banchan86/harp-device.timestampgeneratorgen3/docs/apidoc/Harp_TimestampGeneratorGen3_Config.md

---
uid: Harp.TimestampGeneratorGen3.Config
---

### Charge or discharge the battery

:::workflow
Charge or discharge the battery
:::

### Run battery cycle

:::workflow
Run battery cycle
:::
