banchan86/harp-device.timestampgeneratorgen3/docs/apidoc/Harp_TimestampGeneratorGen3_CreateTimerFrequencyPayload.md

---
uid: Harp.TimestampGeneratorGen3.CreateTimerFrequencyPayload
---

### Enable Timer events

:::workflow
Enable Timer events
:::
