banchan86/harp-device.timestampgeneratorgen3/docs/apidoc/Harp_TimestampGeneratorGen3_TimerFrequency.md

---
uid: Harp.TimestampGeneratorGen3.TimerFrequency
---

### Enable Timer events

:::workflow
Enable Timer events
:::
