banchan86/harp-device.timestampgeneratorgen3/docs/apidoc/Harp_TimestampGeneratorGen3_BatteryRate.md

---
uid: Harp.TimestampGeneratorGen3.BatteryRate
---

### Configure the battery rate

:::workflow
Configure the battery rate
:::
