banchan86/harp-device.timestampgeneratorgen3/docs/apidoc/Harp_TimestampGeneratorGen3_BatteryThresholdLow.md

---
uid: Harp.TimestampGeneratorGen3.BatteryThresholdLow
---

### Set charging thresholds

:::workflow
Set charging thresholds
:::
