banchan86/harp-device.timestampgeneratorgen3/docs/apidoc/Harp_TimestampGeneratorGen3_CreateBatteryRatePayload.md

---
uid: Harp.TimestampGeneratorGen3.CreateBatteryRatePayload
---

### Configure the battery rate

:::workflow
Configure the battery rate
:::
