banchan86/harp-device.timestampgeneratorgen3/docs/apidoc/Harp_TimestampGeneratorGen3_Battery.md

---
uid: Harp.TimestampGeneratorGen3.Battery
---

### Check battery charge

:::workflow
Check battery charge
:::

### Visualize battery events

:::workflow
Visualize battery events
:::
