banchan86/harp-device.timestampgeneratorgen3/docs/apidoc/Harp_TimestampGeneratorGen3_BatteryThresholdHigh.md

---
uid: Harp.TimestampGeneratorGen3.BatteryThresholdHigh
---

### Set charging thresholds

:::workflow
Set charging thresholds
:::
