banchan86/harp-device.timestampgeneratorgen3/docs/apidoc/Harp_TimestampGeneratorGen3_CreateBatteryThresholdLowPayload.md

---
uid: Harp.TimestampGeneratorGen3.CreateBatteryThresholdLowPayload
---

### Set charging thresholds

:::workflow
Set charging thresholds
:::
