banchan86/harp-device.timestampgeneratorgen3/docs/apidoc/Harp_TimestampGeneratorGen3_DeviceDataWriter.md

---
uid: Harp.TimestampGeneratorGen3.DeviceDataWriter
---

### Harp device pattern

:::workflow
Harp device pattern
:::
