banchan86/harp-device.timestampgeneratorgen3/docs/apidoc/Harp_TimestampGeneratorGen3_Timer.md

---
uid: Harp.TimestampGeneratorGen3.Timer
---

### Set Counter Value

:::workflow
Set Counter Value
:::

### Observe Timer Events

:::workflow
Observe Timer Events
:::

### Timestamp Software Events

:::workflow
Timestamp Software Events
:::
