banchan86/harp-device.timestampgeneratorgen3/docs/apidoc/Harp_TimestampGeneratorGen3_CreateBatteryThresholdHighPayload.md

---
uid: Harp.TimestampGeneratorGen3.CreateBatteryThresholdHighPayload
---

### Set Charging Thresholds

:::workflow
Set Charging Thresholds
:::
