banchan86/harp-device.timestampgeneratorgen3/docs/apidoc/Harp_TimestampGeneratorGen3_DevicesConnected.md

---
uid: Harp.TimestampGeneratorGen3.DevicesConnected
---

### Check Connected Devices

:::workflow
Check Connected Devices
:::
