banchan86/harp-device.timestampgeneratorgen3/docs/articles/generate-counter-events.md

# Generate counter events

Besides the [heartbeat](./set-clock.md) event, the Timestamp Generator Gen3 can also report a high-frequency counter (50–1000 Hz) as [`Timer`] events. Each event carries an incrementing value timestamped with the device clock, which is useful for inspecting the clock and detecting dropped messages.  It can also be used to assign Harp timestamps to data that are not generated by Harp devices, such as software-generated events, thereby timestamping them on the same clock as the Harp devices.

This article covers how to enable and visualize the [`Timer`] events, set the counter value, and assign Harp timestamps to software events.

The complete workflow is shown below. Copy and paste it into Bonsai to get started immediately, or build each section by following the step-by-step instructions in the following sections.

:::workflow
Generate counter events
:::

> [!NOTE]
> The [`Timer`] event is different from the [`Timer (Reactive)`] Bonsai operator used in the [Set clock](set-clock.md#alternative-set-clock-with-timer) article. [`Timer`] is an event from a hardware counter on the device, whereas [`Timer (Reactive)`] is a software trigger in Bonsai that uses the operating system clock to count elapsed time.

> [!WARNING]
> For the rest of these workflows, use the device-specific versions of the operators, e.g. `Device (Harp.TimestampGeneratorGen3)` instead of `Device (Harp)`. If correctly selected, the names of these operators in the workflow panel will change to reflect either the name of the device or the selected register/payload.

## Enable Timer events

The [`Timer`] events are disabled by default, so set the [`TimerFrequency`] to start them.

:::workflow
Enable Timer events
:::

- Insert a [`KeyDown`] operator and set the `Filter` property to `A`.
- Insert a [`CreateMessage`] operator and configure the following properties:
    - `Payload` - Select `TimerFrequencyPayload`.
    - `TimerFrequency` - Select the event frequency (e.g. `Timer50Hz` to generate 50 counts per second). To disable the events in the future, select `Disabled`.
- Insert a [`MulticastSubject`] operator named `TimestampGeneratorGen3 Commands`.

Run the workflow and press <kbd>A</kbd>. The device starts reporting [`Timer`] events at 50 Hz (covered in the next section).

## Visualize Timer events

Each [`Timer`] event carries the current counter value and the timestamp at which it was generated. The workflow below will show you how to decode and visualize the [`Timer`] events:

:::workflow
Visualize Timer events
:::

- Insert a [`SubscribeSubject`] operator named `TimestampGeneratorGen3 Events`.
- Insert a [`Parse`] operator and set the `Register` property to `TimestampedTimer`.
- Insert a [`VisualizerWindow`] operator.

Run the workflow and press <kbd>A</kbd> to enable the counter. The visualizer will display:

```text
4778@95.563344
4779@95.583344
```

The first number is the counter value, and the second number is the timestamp on the device clock.

> [!NOTE]
> To detect dropped messages, analyze the logged data to check that the counter is increasing sequentially by one without any skipped numbers.

## Set counter value

Writing a value to [`Timer`] sets the value of the counter. This is useful for resetting the counter to zero at the start of a session.

:::workflow
Set counter value
:::

- Insert a [`KeyDown`] operator and set the `Filter` property to `S`.
- Insert a [`CreateMessage`] operator and configure the following properties:
    - `Payload` - Select `TimerPayload`.
    - `Timer` - Enter `0` to reset the counter.
- Insert a [`MulticastSubject`] operator named `TimestampGeneratorGen3 Commands`.

Run the workflow and press <kbd>S</kbd>. The counter value in the visualizer window resets to zero, like this:

```text
0@99.563344
1@99.583344
```

> [!TIP]
> To reset the onboard clock that timestamps the events, see the [Set clock](set-clock.md) article.

## Timestamp software events

Software events, such as key presses, can be assigned Harp timestamps by pairing them with the latest [`Timer`] event.

:::workflow
Timestamp software events
:::

- Insert a [`KeyDown`] operator and set the `Filter` property to `D`. This is the software event that will be timestamped.
- Insert a [`WithLatestFrom`] operator.

In a separate branch:

- Insert a [`SubscribeSubject`] operator named `TimestampGeneratorGen3 Events`.
- Insert a [`Parse`] operator and set the `Register` property to `TimestampedTimer`.

To combine the two branches:

- Connect the [`Parse`] operator to the [`WithLatestFrom`]. Each key press will now be paired with the latest [`Timer`] event.
- Insert a [`VisualizerWindow`] operator to display the paired events.

Run the workflow and press <kbd>D</kbd>. Each key press appears in the visualizer window paired with the latest counter and timestamp:

```text
(D, 141404@19990.36)
(D, 146440@20000.66)
```

> [!NOTE]
> The timestamp resolution with this strategy is set by the [`TimerFrequency`] (e.g. 20 ms at 50 Hz). Use a higher frequency for finer resolution. The pairing is done in software by Bonsai, and Windows is not a real-time operating system, so it is not ideal for high-precision timing applications. For that, log the events on a hardware clock instead, such as a digital input on another Harp device.

[!INCLUDE [](../includes/version-footer.md)]

<!--Reference Style Links -->
[`Timer`]: xref:Harp.TimestampGeneratorGen3.Timer
[`TimerFrequency`]: xref:Harp.TimestampGeneratorGen3.TimerFrequency
[`Timer (Reactive)`]: xref:Bonsai.Reactive.Timer
[`CreateMessage`]: xref:Harp.TimestampGeneratorGen3.CreateMessage
[`Parse`]: xref:Harp.TimestampGeneratorGen3.Parse
[`VisualizerWindow`]: xref:Bonsai.Design.VisualizerWindow
[`KeyDown`]: xref:Bonsai.Windows.Input.KeyDown
[`SubscribeSubject`]: xref:Bonsai.Expressions.SubscribeSubject
[`WithLatestFrom`]: xref:Bonsai.Reactive.WithLatestFrom
[`MulticastSubject`]: xref:Bonsai.Expressions.MulticastSubject
