banchan86/harp-device.timestampgeneratorgen3/Hardware/PCB/README.md

# Harp Timestamp Generator Gen1

## Licensing

The designs, documentation, and photos available in this repository are free: you can redistribute it and/or modify it under the terms of the used license.
Check file named LICENSE.

Copyright OEPS 2021-2026

<br />This work is licensed under a <a rel="license" href="http://creativecommons.org/licenses/by-nc-sa/3.0/igo/">Creative Commons Attribution-NonCommercial-ShareAlike 3.0 IGO License</a>.

If your are interested in obtaining a license to sell this device, please contact info@oeps.tech

[1]: https://docs.google.com/spreadsheets/d/1aobmmEzBDethzIlrm1eg0eYkBqlyX3s9WbA9KgRwVQI/edit?usp=sharing
