banchan86/harp-device.timestampgeneratorgen3/hardware/PCB/timestamp generator Gen3/manufacturing/bom/harp timestamp generator Gen3.csv

# | Qty | Reference | Value | Tolerance | Footprint | TempCo | Voltage | DNP | OEPSPN | MPN | OEPS Description
1 | 1 | BATEN1 | 7101MD9ABE |  | harp_timestamp_generator_Gen3:2M1-SP1-T2-B4-M6RE |  |  |  | OEPS100019 | 7101MD9ABE | OTHER: SWITCH TOGGLE SPDT 0.4VA 20V [7101MD9ABE] [TH]
2 | 1 | BUTTON1 | CFPA |  | harp_timestamp_generator_Gen3:CFPA |  |  |  | OEPS100018 | CFPA-1FB4-A2T | OTHER: SWITCH PUSH SPDT 0.4VA 28V [CFPA-1FB4-A2T] [SMD]
3 | 1 | C1 | 4.7nF | 10% | Capacitor_SMD:C_0402_1005Metric | X7R | 100V |  | OEPS010017 | 885012205084 | CAPACITOR: SMD CER 0402 4.7nF 100V ±10% X7R [885012205084] [SMD]
4 | 30 | C2,C3,C5,C8,C9,C10,C12,C16,C19,C20,C21,C23,C24,C25,C26,C27,C28,C29,C30,C31,C32,C33,C34,C35,C36,C39,C40,C41,C42,C43 | 100nF | 10% | Capacitor_SMD:C_0402_1005Metric | X7R | 50V |  | OEPS010016 | CGA2B3X7R1H104K050BB | CAPACITOR: SMD CER 0402 100nF 50V ±10% X7R [CGA2B3X7R1H104K050BB] [SMD]
5 | 5 | C4,C14,C15,C37,C38 | 4.7uF | 10% | Capacitor_SMD:C_0603_1608Metric | X6S | 16V |  | OEPS010018 | C1608X6S1C475K080AC | CAPACITOR: SMD CER 0603 4.7uF 16V ±10% X6S [C1608X6S1C475K080AC] [SMD]
6 | 2 | C6,C7 | 47pF | 5% | Capacitor_SMD:C_0402_1005Metric | C0G | 50V |  | OEPS010011 | 04025A470JAT2A | CAPACITOR: SMD CER 0402 47pF 50V ±5% C0G [04025A470JAT2A] [SMD]
7 | 1 | C11 | 100u | 20% | harp_timestamp_generator_Gen3:TT2D6_334 |  | 25V |  | OEPS210005 | EEU-FM1E101B | CAPACITOR POL: TH ALUM 100uF 25V ±20% 130mOhm [EEU-FM1E101B] [TH]
8 | 2 | C13,C17 | 10nF | 10% | Capacitor_SMD:C_0402_1005Metric | X7R | 25V |  | OEPS010002 | GCM155R71E103KA37D | CAPACITOR: SMD CER 0402 10nF 25V ±10% X7R [GCM155R71E103KA37D] [SMD]
9 | 1 | C18 | 330pF | 5% | Capacitor_SMD:C_0402_1005Metric | C0G | 50V |  | OEPS010020 | C0402C331J5GAC7867 | CAPACITOR: SMD CER 0402 330pF 50V ±5% C0G [C0402C331J5GAC7867] [SMD]
10 | 1 | C22 | 330nF | 10% | Capacitor_SMD:C_0402_1005Metric | X5R | 10V |  | OEPS010021 | GRM155R61A334KE15D | CAPACITOR: SMD CER 0402 330nF 10V ±10% X5R [GRM155R61A334KE15D] [SMD]
11 | 7 | CLKIN1,CLKOUT1,CLKOUT2,CLKOUT3,CLKOUT4,CLKOUT5,CLKOUT6 | 35RASMT2BHNTRX |  | harp_timestamp_generator_Gen3:35RASMT2BHNTRX |  |  |  | OEPS070025 | 35RASMT2BHNTRX | CONNECTOR: 3.5MM JACK STEREO 90º [35RASMT2BHNTRX] [SMD]
12 | 4 | D1,D2,D3,D4 | CDBW140-G |  | Diode_SMD:D_SOD-123 |  | 40V |  | OEPS030034 | CDBW140-G | DIODE: DIODE SCHOTTKY 40V 1A [CDBW140-G] [SOD-123]
13 | 1 | F1 | BLM18SG331TN1D |  | Resistor_SMD:R_0603_1608Metric |  |  |  | OEPS040004 | BLM18SG331TN1D | INDUCTOR: FERRITE BEAD SMD 330Ω 1.5A 70mΩ [BLM18SG331TN1D] [0603]
14 | 1 | IC1 | USBLC6-2SC6 |  | Package_TO_SOT_SMD:SOT-23-6 |  |  |  | OEPS030010 | USBLC6-2SC6 | DIODE: TVS DIODE 5.25VWM 17VC [USBLC6-2SC6] [SOT-23-6]
15 | 1 | IC2 | FT232RL |  | Package_SO:SSOP-28_5.3x10.2mm_P0.65mm |  |  |  | OEPS080013 | FT232RL-REEL | IC: USB Interface IC USB to Serial UART (OEPS NP1 073) [FT232RL-REEL] [SSOP-28]
16 | 1 | IC3 | TPS2114 |  | Package_SO:TSSOP-8_4.4x3mm_P0.65mm |  |  |  | OEPS080039 | TPS2114APW | IC: AUTOSWITCHING POWER MUX [TPS2114APW] [8-TSSOP]
17 | 2 | IC4,IC14 | LP5951MFX-3.3/NOPB |  | Package_TO_SOT_SMD:TSOT-23-5 |  |  |  | OEPS080026 | LP5951MFX-3.3/NOPB | IC: LDO 3.3V 150mA [LP5951MFX-3.3/NOPB] [SOT-23-5]
18 | 1 | IC5 | MCP73831 |  | Package_TO_SOT_SMD:TSOT-23-5 |  |  |  | OEPS080035 | MCP73831T-2ATI/OT | IC: BATTERY LI-POLYMER CHARGER [MCP73831T-2ATI/OT] [SOT-23-5]
19 | 1 | IC6 | ATXMEGA16A4U-A |  | Package_QFP:LQFP-44_10x10mm_P0.8mm |  |  |  | OEPS080032 | ATXMEGA16A4U-AU | IC: MCU ATXMEGA A4U 8bits 16KB [ATXMEGA16A4U-AU] [TQFP-44]
20 | 3 | IC7,IC8,IC17 | SN74LVC1G125DBVT |  | Package_TO_SOT_SMD:SOT-23-5 |  |  |  | OEPS080029 | SN74LVC1G125DBVT | IC: BUFFER NON-INVERT 1CH 3-STATE [SN74LVC1G125DBVT] [SOT-23-5]
21 | 6 | IC9,IC10,IC11,IC12,IC13,IC15 | SI8621BC |  | Package_SO:SOIC-8_3.9x4.9mm_P1.27mm |  |  |  | OEPS080031 | SI8621BC-B-ISR | IC: DIGITAL ISOLATOR 1+1WAY [SI8621BC-B-ISR] [8-SOIC]
22 | 2 | IC16,IC18 | M74VHC1GT126DF1G |  | Package_TO_SOT_SMD:SOT-353_SC-70-5 |  |  |  | OEPS080033 | M74VHC1GT126DF1G | IC: BUFFER NON-INVERT 1CH 3-STATE [M74VHC1GT126DF1G] [SC-70-5]
23 | 1 | L1 | MI0805K400R-10 |  | Resistor_SMD:R_0805_2012Metric |  |  |  | OEPS040003 | MI0805K400R-10 | INDUCTOR: FERRITE BEAD SMD 40Ω 2A 50mΩ [MI0805K400R-10] [0805]
24 | 5 | LED1,LED2,LED3,LED4,LED5 | 569-0111-100F |  | harp_timestamp_generator_Gen3:569-011X-X00_LED_ARRAY |  |  |  | OEPS030007 | 569-0111-100F | DIODE: LED DUAL Red 635nm 20mA [569-0111-100F] [TH]
25 | 1 | OSC1 | ECS-TXO-3225MV-320-TR |  | harp_timestamp_generator_Gen3:OSCILLATOR_3.2X2.5 |  |  |  | OEPS080257 | ECS-TXO-3225MV-320-TR | IC: XTAL OSC TCXO 32MHz HCMOS 2.5ppm [ECS-TXO-3225MV-320-TR] [4-SMD]
26 | 1 | PDI1 | 67996-206HLF |  | Connector_PinHeader_2.54mm:PinHeader_2x03_P2.54mm_Vertical |  |  |  | OEPS070015 | 67996-206HLF | CONNECTOR: HEADER 2.54MM straight 2x3POS [67996-206HLF] [TH]
27 | 2 | Q1,Q6 | DMG1012UW |  | Package_TO_SOT_SMD:SOT-323_SC-70 |  |  |  | OEPS060010 | DMG1012UW-7 | TRANSISTOR: MOSFET N-CH 20V 1A [DMG1012UW-7] [SOT-323]
28 | 1 | Q2 | SBC817 |  | Package_TO_SOT_SMD:SOT-23 |  |  |  | OEPS060008 | SBC817-40LT1G | TRANSISTOR: BJT NPN 45V 0.5A [SBC817-40LT1G] [SOT-23-3]
29 | 1 | Q3 | PJC7401_R1_00001 |  | Package_TO_SOT_SMD:SOT-323_SC-70 |  |  | DNP | OEPS060026 | PJC7401_R1_00001 | TRANSISTOR: MOSFET P-CH 30V 1.5A [PJC7401_R1_00001] [SOT-323]
30 | 1 | Q4 | DMP2035U-7 |  | Package_TO_SOT_SMD:SOT-23 |  |  |  | OEPS060011 | DMP2035U-7 | TRANSISTOR: MOSFET P-CH 20V 3.6A [DMP2035U-7] [SOT-23-3]
31 | 1 | Q5 | PJC7401_R1_00001 |  | Package_TO_SOT_SMD:SOT-323_SC-70 |  |  |  | OEPS060026 | PJC7401_R1_00001 | TRANSISTOR: MOSFET P-CH 30V 1.5A [PJC7401_R1_00001] [SOT-323]
32 | 1 | Q7 | BC817-40W |  | Package_TO_SOT_SMD:SOT-323_SC-70 |  |  |  | OEPS060007 | BC817-40W,135 | TRANSISTOR: BJT NPN 45V 0.5A [BC817-40W,135] [SOT-323]
33 | 1 | R1 | 1M | 1% | Resistor_SMD:R_0402_1005Metric |  |  |  | OEPS020026 | CRCW04021M00FKED | RESISTOR: SMD 0402 1MΩ ±1% 0.063W [CRCW04021M00FKED] [SMD]
34 | 9 | R2,R7,R15,R20,R22,R23,R24,R26,R48 | 10k | 1% | Resistor_SMD:R_0402_1005Metric |  |  |  | OEPS020030 | CRCW040210K0FKED | RESISTOR: SMD 0402 10kΩ ±1% 0.063W [CRCW040210K0FKED] [SMD]
35 | 2 | R3,R4 | 5.1k | 1% | Resistor_SMD:R_0402_1005Metric |  |  |  | OEPS020173 | ERJ-2RKF5101X | RESISTOR: SMD 0402 5.1kΩ ±1% 0.100W [ERJ-2RKF5101X] [SMD]
36 | 2 | R5,R6 | DNP |  | Resistor_SMD:R_0402_1005Metric |  |  | DNP | OEPS000000 | DNP | DNP: Do Not Populate (DNI)
37 | 1 | R8 | 20R | 1% | Resistor_SMD:R_2512_6332Metric |  |  |  | OEPS020045 | CRM2512-FX-20R0ELF | RESISTOR: SMD 2512 20Ω ±1% 2W [CRM2512-FX-20R0ELF] [SMD]
38 | 2 | R9,R21 | 100k | 1% | Resistor_SMD:R_0402_1005Metric |  |  |  | OEPS020019 | ERJ-2RKF1003X | RESISTOR: SMD 0402 100kΩ ±1% 0.100W [ERJ-2RKF1003X] [SMD]
39 | 12 | R10,R32,R33,R34,R35,R36,R42,R43,R44,R45,R46,R_I_MAX1 | 1k | 1% | Resistor_SMD:R_0402_1005Metric |  |  |  | OEPS020027 | CRCW04021K00FKED | RESISTOR: SMD 0402 1kΩ ±1% 0.063W [CRCW04021K00FKED] [SMD]
40 | 1 | R11 | 100k | 1% | Resistor_SMD:R_0402_1005Metric |  |  | DNP | OEPS020019 | ERJ-2RKF1003X | RESISTOR: SMD 0402 100kΩ ±1% 0.100W [ERJ-2RKF1003X] [SMD]
41 | 1 | R12 | 100R | 1% | Resistor_SMD:R_0603_1608Metric |  |  | DNP | OEPS020042 | CRCW0603100RFKEAHP | RESISTOR: SMD 0603 100Ω ±1% 0.333W [CRCW0603100RFKEAHP] [SMD]
42 | 3 | R13,R14,R17 | 4.53k | 0.1% | Resistor_SMD:R_0402_1005Metric |  |  |  | OEPS020040 | RT0402BRD074K53L | RESISTOR: SMD 0402 4.53kΩ ±0.1% 0.063W [RT0402BRD074K53L] [SMD]
43 | 2 | R16,R19 | 14.7k | 0.1% | Resistor_SMD:R_0402_1005Metric |  |  |  | OEPS020047 | RT0402BRD0714K7L | RESISTOR: SMD 0402 14.7kΩ ±0.1% 0.063W [RT0402BRD0714K7L] [SMD]
44 | 1 | R18 | 51k | 0.1% | Resistor_SMD:R_0402_1005Metric |  |  |  | OEPS020046 | ERA-2AEB513X | RESISTOR: SMD 0402 51kΩ ±0.1% 0.063W [ERA-2AEB513X] [SMD]
45 | 1 | R25 | 10R | 5% | Resistor_SMD:R_0402_1005Metric |  |  |  | OEPS020041 | ERJ-PA2J100X | RESISTOR: SMD 0402 10Ω ±5% 0.25W [ERJ-PA2J100X] [SMD]
46 | 10 | R27,R28,R29,R30,R31,R37,R38,R39,R40,R41 | 330R | 1% | Resistor_SMD:R_0402_1005Metric |  |  |  | OEPS020037 | RC0402FR-07330RL | RESISTOR: SMD 0402 330Ω ±1% 0.063W [RC0402FR-07330RL] [SMD]
47 | 2 | R47,R49 | 100R | 1% | Resistor_SMD:R_0603_1608Metric |  |  |  | OEPS020042 | CRCW0603100RFKEAHP | RESISTOR: SMD 0603 100Ω ±1% 0.333W [CRCW0603100RFKEAHP] [SMD]
48 | 1 | SV1 | SBH11-PBPC-D05-RA-BK |  | Connector_IDC:IDC-Header_2x05_P2.54mm_Horizontal |  |  |  | OEPS070027 | SBH11-PBPC-D05-RA-BK | CONNECTOR: HEADER 2.54MM R/A 2x5POS [SBH11-PBPC-D05-RA-BK] [TH]
49 | 10 | T1,T2,T3,T4,T5,T6,T7,T8,T9,T10 | BC850 |  | Package_TO_SOT_SMD:SOT-23 |  |  |  | OEPS060006 | BC850C,215 | TRANSISTOR: BJT NPN 45V 0.1A [BC850C,215] [SOT-23-3]
50 | 1 | U1 | XC6135C35AMR-G |  | Package_TO_SOT_SMD:SOT-23-5 |  |  |  | OEPS080252 | XC6135C35AMR-G | IC: ULTRA-LOW POWER (44nA) VOLTAGE DETECTOR [XC6135C35AMR-G] [SOT-25]
51 | 1 | USB1 | USB4105-GF-A |  | Connector_USB:USB_C_Receptacle_GCT_USB4105-xx-A_16P_TopMnt_Horizontal |  |  |  | OEPS070105 | USB4105-GF-A | CONNECTOR: USB2.0 TYPE C 16P SMD R/A [USB4105-GF-A] [SMD/TH]
52 | 1 | X1 | B2B-XH-A(LF)(SN) |  | harp_timestamp_generator_Gen3:JST-XH-02-PACKAGE-ROUND-PAD |  |  |  | OEPS070028 | B2B-XH-A(LF)(SN) | CONNECTOR: HEADER JST VERT 2.5MM 2POS [B2B-XH-A(LF)(SN)] [TH]
