banchan86/harp-device.timestampgeneratorgen3/hardware/PCB/timestamp generator Gen3/crystals.xlsx

Digikey PN | MNF PN | @25C [ppm] | Range of temperatures [ppm] | Supply Change [ppm] | Load Change [ppm] | Aging/year [ppm] |  | Dimensions [mm] | Pinout | Current [mA] | Type
XC2259CT-ND | ECS-TXO-2520-33-320-AN-TR | 2 | 2.5 | 0.2 | 0.2 | 1 | 5.9 | 2.5 x 2.0 | En/Dis, GND, OUT, VDD | 6 | HCMOS TXCO
1908-1044-1-ND | O 32,0-JT32C-A-K-3,3-LF | 0.5 | 2.5 | 0.2 | 0.2 | 1 | 4.4 | 3.2 x 2.5 | En/Dis, GND, OUT, VDD | 4.8 | HCMOS TXCO
50-ECS-TXO-2520MV-320-AN-CT-ND | ECS-TXO-2520MV-320-AN-TR | 1.5 | 2.5 | 0.3 | 0.3 | 1 | 5.6 | 2.5 x 2.0 | En/Dis, GND, OUT, VDD | 6 | CMOS TXCO
50-ECS-TXO-2520MV-320-AY-CT-ND | ECS-TXO-2520MV-320-AY-TR | 1.5 | 2.5 | 0.3 | 0.3 | 1 | 5.6 | 2.5 x 2.0 | En/Dis, GND, OUT, VDD | 6 | CMOS TXCO
50-ECS-TXO-25CSMV-320-BM-CT-ND | ECS-TXO-25CSMV-320-BM-TR | 2 | 1 | 0.2 | 0.2 | 1 | 4.4 | 2.5 x 2.0 | GND, GND, OUT, VDD | 2.5 | Clipped Sinewave TSCO
