banchan86/harp-device.timestampgeneratorgen3/hardware/PCB/timestamp generator Gen3/harp timestamp generator Gen3.kicad_pcb

## KiCad design hardware/PCB/timestamp generator Gen3/harp timestamp generator Gen3.kicad_pcb (2026-11-14)

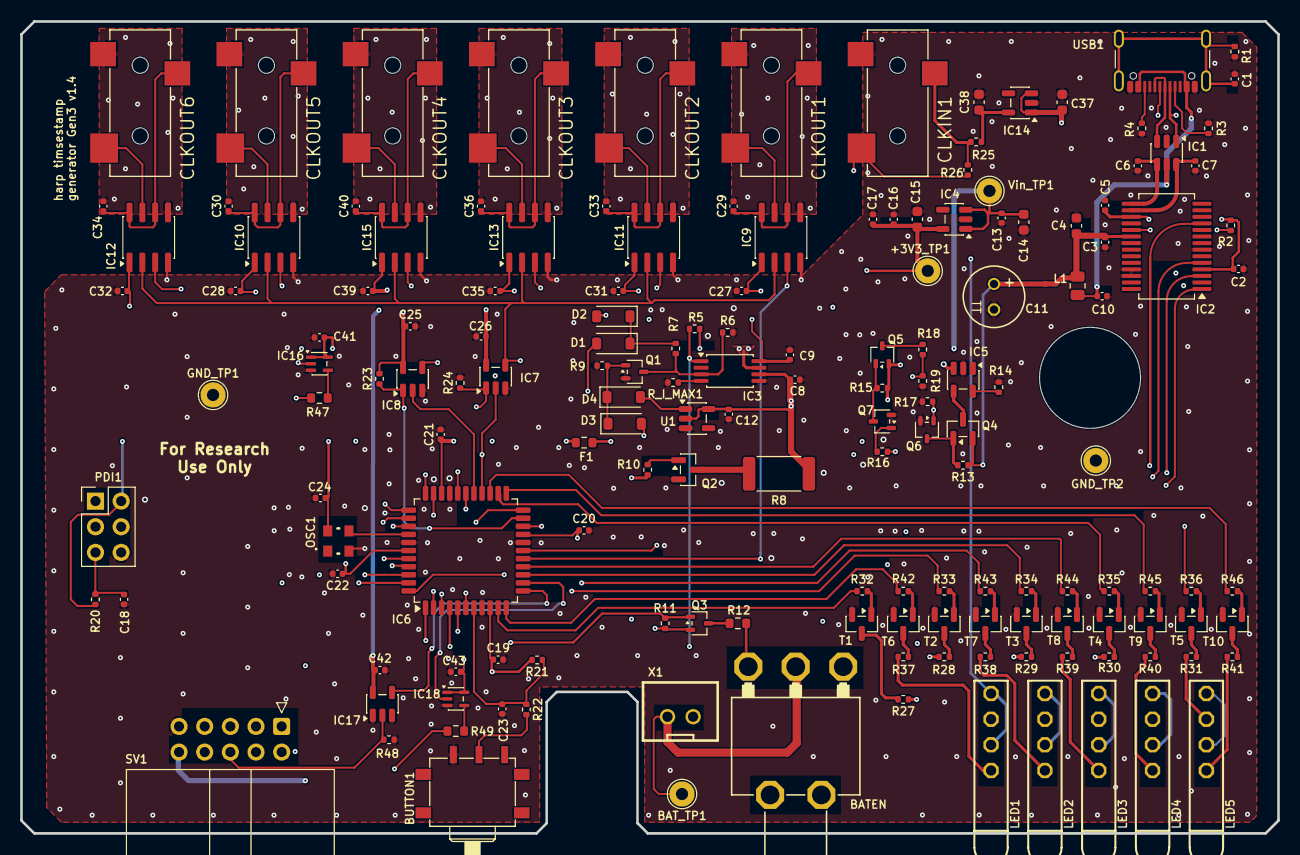
[picture p5: board harp timestamp generator Gen3.kicad_pcb from above]

Board: 4 copper layers, 124.5 x 80.4 mm, 159 parts (0 on the bottom side), 124 nets.

Parts:
+3V3_TP1: TPPAD1-13; TestPoint_THTPad_D2.5mm_Drill1.2mm
BATEN1: 7101MD9ABE; 2M1-SP1-T2-B4-M6RE
BAT_TP1: TPPAD1-13; TestPoint_THTPad_D2.5mm_Drill1.2mm
BUTTON1: CFPA
C1: 4.7nF; C_0402_1005Metric
C2, C3, C5, C8, C9, C10, C12, C16, C19, C20, C21, C23, C24, C25, C26, C27, C28, C29, C30, C31, C32, C33, C34, C35, C36, C39, C40, C41, C42, C43: 100nF; C_0402_1005Metric
C4, C14, C15, C37, C38: 4.7uF; C_0603_1608Metric
C6, C7: 47pF; C_0402_1005Metric
C11: 100u; TT2D6_334
C13, C17: 10nF; C_0402_1005Metric
C18: 330pF; C_0402_1005Metric
C22: 330nF; C_0402_1005Metric
CLKIN1: 35RASMT2BHNTRX
CLKOUT1, CLKOUT2, CLKOUT3, CLKOUT4, CLKOUT5, CLKOUT6: 35RASMT2BHNTRX
D1, D2, D3, D4: CDBW140-G; D_SOD-123
F1: BLM18SG331TN1D; R_0603_1608Metric
GND_TP1, GND_TP2: TPPAD1-13; TestPoint_THTPad_D2.5mm_Drill1.2mm
IC1: USBLC6-2SC6; SOT-23-6
IC2: FT232RL; SSOP-28_5.3x10.2mm_P0.65mm
IC3: TPS2114; TSSOP-8_4.4x3mm_P0.65mm
IC4, IC14: LP5951MFX-3.3/NOPB; TSOT-23-5
IC5: MCP73831; TSOT-23-5
IC6: ATXMEGA16A4U-A; LQFP-44_10x10mm_P0.8mm
IC7, IC8, IC17: SN74LVC1G125DBVT; SOT-23-5
IC9, IC10, IC11, IC12, IC13, IC15: SI8621BC; SOIC-8_3.9x4.9mm_P1.27mm
IC16, IC18: M74VHC1GT126DF1G; SOT-353_SC-70-5
L1: MI0805K400R-10; R_0805_2012Metric
LED1, LED2, LED3, LED4, LED5: 569-0111-100F; 569-011X-X00_LED_ARRAY
OSC1: ECS-TXO-3225MV-320-TR; OSCILLATOR_3.2X2.5
PDI1: 67996-206HLF; PinHeader_2x03_P2.54mm_Vertical
Q1, Q6: DMG1012UW; SOT-323_SC-70
Q2: SBC817; SOT-23
Q3, Q5: PJC7401_R1_00001; SOT-323_SC-70
Q4: DMP2035U-7; SOT-23
Q7: BC817-40W; SOT-323_SC-70
R1: 1M; R_0402_1005Metric
R2, R7, R15, R20, R22, R23, R24, R26, R48: 10k; R_0402_1005Metric
R3, R4: 5.1k; R_0402_1005Metric
R5, R6: DNP; R_0402_1005Metric
R8: 20R; R_2512_6332Metric
R9, R11, R21: 100k; R_0402_1005Metric
R10, R32, R33, R34, R35, R36, R42, R43, R44, R45, R46: 1k; R_0402_1005Metric
R12, R47, R49: 100R; R_0603_1608Metric
R13, R14, R17: 4.53k; R_0402_1005Metric
R16, R19: 14.7k; R_0402_1005Metric
R18: 51k; R_0402_1005Metric
R25: 10R; R_0402_1005Metric
R27, R28, R29, R30, R31, R37, R38, R39, R40, R41: 330R; R_0402_1005Metric
R_I_MAX1: 1k; R_0402_1005Metric
SV1: SBH11-PBPC-D05-RA-BK; IDC-Header_2x05_P2.54mm_Horizontal
T1, T2, T3, T4, T5, T6, T7, T8, T9, T10: BC850; SOT-23
U1: XC6135C35AMR-G; SOT-23-5
USB1: USB4105-GF-A; USB_C_Receptacle_GCT_USB4105-xx-A_16P_TopMnt_Horizontal
Vin_TP1: TPPAD1-13; TestPoint_THTPad_D2.5mm_Drill1.2mm
X1: B2B-XH-A(LF)(SN); JST-XH-02-PACKAGE-ROUND-PAD

Connections:
+3V3: +3V3_TP1.1 (1_1), C15.1, C16.1, C17.1, C25.1, C26.1, C27.1, C28.1, C31.1, C32.1, C35.1, C39.1, C42.1, F1.2, IC4.5 (OUT), IC7.5 (VCC), IC8.5 (VCC), IC9.1 (AVDD), IC10.1 (AVDD), IC11.1 (AVDD), IC12.1 (AVDD), IC13.1 (AVDD), IC15.1 (AVDD), IC17.5 (VCC), LED1.A1 (A), LED1.A2 (A), LED2.A1 (A), LED2.A2 (A), LED3.A1 (A), LED3.A2 (A), LED4.A1 (A), LED4.A2 (A), LED5.A1 (A), LED5.A2 (A), Q3.2 (S), R11.2, R23.2
+3V3Out: C2.1, C5.1, IC2.4 (VCCIO), IC2.17 (3V3OUT), R2.1
+3V3_u: C19.1, C20.1, C21.1, C22.1, C24.1, F1.1, IC6.9 (VCC@1), IC6.19 (VCC@2), IC6.31 (VCC@3), IC6.39 (AVCC), OSC1.P$4 (VDD), PDI1.2, R20.2, R21.2
+5V_USB: C3.1, C4.1, C9.1, C11.1, D2.2 (A), D3.2 (A), IC2.20 (VCC), IC3.8 (IN1), L1.1, Q4.2 (S), R13.1
+5V_USBIn: C10.1, IC1.5 (VBUS), L1.2, USB1.A4 (VBUS), USB1.A9 (VBUS), USB1.B4 (VBUS), USB1.B9 (VBUS)
/BAT_READ: IC6.41 (PA1/ADC1), R16.1
/BAT_VOLTAGE: IC6.40 (PA0/ADC0/AREF), R18.2, R19.1
/BAT_WAKEUP: IC6.1 (PA5/ADC5), Q3.1 (G), R11.1
/CHARGE_ENABLE: IC6.5 (PB1/ADC9), Q6.1 (G), R17.1
/DISCHARGE_BAT: IC6.6 (PB2/ADC10/DAC0), R10.1
/FTDI_CTS: IC2.11 (CTS), IC6.29 (~XCK0OC0BSCLPE1)
/FTDI_RTS: IC2.3 (RTS), IC6.28 (~OC0ASDAPE0)
/FTDI_RXD: IC2.5 (RXD), IC6.33 (~TXD0OC0DPE3)
/FTDI_TXD: IC2.1 (TXD), IC6.32 (~RXD0OC0CPE2)
/PWR_GOOD: IC3.1 (STAT), IC6.4 (PB0/ADC8/AREF), R5.2
/USBD+: C6.1, IC1.4 (I/O2), IC2.15 (USBD+)
/USBD-: C7.1, IC1.6 (I/O1), IC2.16 (USBD-)
/core/BUTTON: C23.1, IC6.7 (PB3/ADC11/DAC1), R21.1, R22.2
/core/CLOCK_IN: CLKIN1.2, IC6.26 (~RXD1MISOPD6), IC7.2, R26.2
/core/CLOCK_OUT: IC6.27 (~~TXD1SCKCLKOPD7), IC8.2
/core/CLOCK_OUT_ISO: IC7.4, IC8.4, IC9.2 (A1_IN), IC10.2 (A1_IN), IC11.2 (A1_IN), IC12.2 (A1_IN), IC13.2 (A1_IN), IC15.2 (A1_IN), IC16.2
/core/DEVICE_AT_0: IC6.16 (PC6/MISO/RXD1), IC9.3 (A2_OUT)
/core/DEVICE_AT_1: IC6.17 (PC7/SCK/TXD1/CLKO/EVO), IC11.3 (A2_OUT)
/core/DEVICE_AT_2: IC6.44 (PA4/ADC4), IC13.3 (A2_OUT)
/core/DEVICE_AT_3: IC6.36 (PR0/XTAL2), IC15.3 (A2_OUT)
/core/DEVICE_AT_4: IC6.42 (PA2/ADC2), IC10.3 (A2_OUT)
/core/DEVICE_AT_5: IC6.43 (PA3/ADC3), IC12.3 (A2_OUT)
/core/EN_CLOCK_IN: IC6.22 (~OC0CRXD0PD2), IC7.1, R24.1
/core/EN_CLOCK_OUT: IC6.21 (~OC0BXCK0PD1), IC8.1, R23.1
/core/LED_CLK_0: IC6.10 (PC0/OC0A/SDA), R32.1
/core/LED_CLK_1: IC6.3 (PA7/ADC7/AC0-OUT), R33.1
/core/LED_CLK_2: IC6.14 (PC4/OC1A/#SS), R34.1
/core/LED_CLK_3: IC6.11 (PC1/OC0B/XCK0/SCL), R42.2
/core/LED_CLK_4: IC6.2 (PA6/ADC6), R43.1
/core/LED_CLK_5: IC6.15 (PC5/OC1B/MOSI/XCK1), R44.1
/core/LED_LOCK: IC6.24 (~#SSPD4), R35.1
/core/LED_PWR: IC6.20 (~OC0APD0), R36.1
/core/LED_REP: IC6.23 (~OC0DTXD0PD3), R45.1
/core/LEDs & IDC socket/IDC_CLOCK_OUT: R47.1, SV1.2
/core/LEDs & IDC socket/RX: IC17.2, R48.1, SV1.6
/core/LEDs & IDC socket/TX: R49.1, SV1.4
/core/PDI-CLK: C18.1, IC6.35 (RESET/PDI-CLK), PDI1.5, R20.1
/core/PDI-DATA: IC6.34 (PDI-DATA), PDI1.1
/core/STATE: IC6.25 (~XCK1MOSIPD5), R46.1
/core/UC_RX: IC6.12 (PC2/OC0C/RXD0), IC17.4
/core/UC_TX: IC6.13 (PC3/OC0D/TXD0), IC18.2
GND: BUTTON1.1 (A), C1.2, C2.2, C3.2, C4.2, C5.2, C6.2, C7.2, C8.2, C9.2, C10.2, C11.2, C12.2, C13.2, C14.2, C15.2, C16.2, C17.2, C18.2, C19.2, C20.2, C21.2, C22.2, C23.2, C24.2, C25.2, C26.2, C27.2, C28.2, C31.2, C32.2, C35.2, C37.2, C38.2, C39.2, C41.2, C42.2, C43.2, CLKIN1.1, GND_TP1.1 (1_1), GND_TP2.1 (1_1), IC1.2 (GND), IC2.7 (GND), IC2.18 (GND), IC2.21 (GND), IC2.25 (AGND), IC2.26 (TEST), IC3.5 (GND), IC4.2 (GND), IC5.2 (VSS), IC6.8 (GND@1), IC6.18 (GND@2), IC6.30 (GND@3), IC6.38 (GND@4), IC7.3 (GND), IC8.3 (GND), IC9.4 (AGND), IC10.4 (AGND), IC11.4 (AGND), IC12.4 (AGND), IC13.4 (AGND), IC14.2 (GND), IC15.4 (AGND), IC16.3 (GND), IC17.1, IC17.3 (GND), IC18.3 (GND), OSC1.P$2 (GND), PDI1.6, Q1.2 (S), Q2.2 (E), Q6.2 (S), Q7.2 (E), R1.2, R3.2, R4.2, R6.2, R9.1, R14.1, R17.2, R19.2, R24.2, R48.2, R_I_MAX1.2, SV1.9, T1.2 (E), T2.2 (E), T3.2 (E), T4.2 (E), T5.2 (E), T6.2 (E), T7.2 (E), T8.2 (E), T9.2 (E), T10.2 (E), U1.3 (GND), USB1.A1 (GND), USB1.A12 (GND), USB1.B1 (GND), USB1.B12 (GND), X1.2
unnamed: BATEN1.2 (B), BAT_TP1.1 (1_1), X1.1
unnamed: BUTTON1.2 (B), R22.1
unnamed: CLKIN1.3, R25.2, R26.1
unnamed: D1.1 (K), D2.1 (K), R7.2
unnamed: D3.1 (K), D4.1 (K), Q1.1 (G), R9.2
unnamed: D4.2 (A), U1.1 (RESETB)
unnamed: IC1.1 (I/O1), USB1.A7 (D-), USB1.B7 (D-)
unnamed: IC1.3 (I/O2), USB1.A6 (D+), USB1.B6 (D+)
unnamed: IC2.19 (~RESET), R2.2
unnamed: IC3.3 (D1), Q1.3 (D), R6.1, R7.1
unnamed: IC3.4 (ILIM), R_I_MAX1.1
unnamed: IC5.5 (PROG), R14.2
unnamed: IC5.4 (VDD), Q4.3 (D)
unnamed: IC6.37 (PR1/XTAL1), OSC1.P$3 (OUTPUT)
unnamed: CLKOUT1.2, IC9.7 (B1_OUT)
unnamed: C29.1, CLKOUT1.3, IC9.6 (B2_IN), IC9.8 (BVDD)
unnamed: C29.2, CLKOUT1.1, IC9.5 (BGND)
unnamed: CLKOUT5.2, IC10.7 (B1_OUT)
unnamed: C30.1, CLKOUT5.3, IC10.6 (B2_IN), IC10.8 (BVDD)
unnamed: C30.2, CLKOUT5.1, IC10.5 (BGND)
unnamed: CLKOUT2.2, IC11.7 (B1_OUT)
unnamed: C33.1, CLKOUT2.3, IC11.6 (B2_IN), IC11.8 (BVDD)
unnamed: C33.2, CLKOUT2.1, IC11.5 (BGND)
unnamed: CLKOUT6.2, IC12.7 (B1_OUT)
unnamed: C34.1, CLKOUT6.3, IC12.6 (B2_IN), IC12.8 (BVDD)
unnamed: C34.2, CLKOUT6.1, IC12.5 (BGND)
unnamed: CLKOUT3.2, IC13.7 (B1_OUT)
unnamed: C36.1, CLKOUT3.3, IC13.6 (B2_IN), IC13.8 (BVDD)
unnamed: C36.2, CLKOUT3.1, IC13.5 (BGND)
unnamed: C38.1, IC14.5 (OUT), R25.1
unnamed: CLKOUT4.2, IC15.7 (B1_OUT)
unnamed: C40.1, CLKOUT4.3, IC15.6 (B2_IN), IC15.8 (BVDD)
unnamed: C40.2, CLKOUT4.1, IC15.5 (BGND)
unnamed: IC16.4, R47.2
unnamed: IC18.4, R49.2
unnamed: LED1.C1 (C), R37.1
unnamed: LED1.C2 (C), R27.1
unnamed: LED2.C1 (C), R38.1
unnamed: LED2.C2 (C), R28.1
unnamed: LED3.C1 (C), R39.1
unnamed: LED3.C2 (C), R29.1
unnamed: LED4.C1 (C), R40.1
unnamed: LED4.C2 (C), R30.1
unnamed: LED5.C1 (C), R41.1
unnamed: LED5.C2 (C), R31.1
unnamed: Q2.1 (B), R10.2
unnamed: Q2.3 (C), R8.2
unnamed: Q3.3 (D), R12.2
unnamed: Q4.1 (G), Q6.3 (D), R13.2
unnamed: Q5.3 (D), R18.1
unnamed: Q5.1 (G), Q7.3 (C), R15.1
unnamed: Q7.1 (B), R16.2
unnamed: R32.2, T1.1 (B)
unnamed: R27.2, T1.3 (C)
unnamed: R33.2, T2.1 (B)
unnamed: R28.2, T2.3 (C)
unnamed: R34.2, T3.1 (B)
unnamed: R29.2, T3.3 (C)
unnamed: R35.2, T4.1 (B)
unnamed: R30.2, T4.3 (C)
unnamed: R36.2, T5.1 (B)
unnamed: R31.2, T5.3 (C)
unnamed: R42.1, T6.1 (B)
unnamed: R37.2, T6.3 (C)
unnamed: R43.2, T7.1 (B)
unnamed: R38.2, T7.3 (C)
unnamed: R44.2, T8.1 (B)
unnamed: R39.2, T8.3 (C)
unnamed: R45.2, T9.1 (B)
unnamed: R40.2, T9.3 (C)
unnamed: R46.2, T10.1 (B)
unnamed: R41.2, T10.3 (C)
unnamed: R3.1, USB1.A5 (CC1)
unnamed: R4.1, USB1.B5 (CC2)
unnamed: C1.1, R1.1, USB1.SH (SHIELD)
VBatt: BATEN1.1 (A), C8.1, C12.1, D1.2 (A), IC3.6 (IN2), IC5.3 (VBAT), Q5.2 (S), R8.1, R12.1, R15.2, U1.2 (Vin), U1.5 (Vsens)
Vin: C13.1, C14.1, C37.1, C41.1, C43.1, IC3.7 (OUT), IC4.1 (IN), IC4.3 (EN), IC14.1 (IN), IC14.3 (EN), IC16.1, IC16.5 (VCC), IC18.1, IC18.5 (VCC), R5.1, SV1.10, Vin_TP1.1 (1_1)
