banchan86/harp-device.timestampgeneratorgen3/(commit log)

2026-11-03 Clarify battery limits
2026-11-06 Revise articles and figures
    - Redraw figures to new template style
    - Add note to clarify distinction between Timer event and operator
    - Add missing visualizer output to examples
    - Edit battery charging article for clarity
2026-11-06 Added new battery handle circuitry.
    1. Ability to turn of below 3.5 V.
    2. Ability to give a short pulse to wake up the battery.
2026-11-11 DNP faulty battery path components
    Mark Q3, R11, and R12 as do-not-populate because Q3's body diode can feed VBatt into the 3.3 V rail. Update the P-channel MOSFET part details and split Q3 and Q5 into separate BOM entries.
2026-11-11 Update battery thresholds
2026-11-11 Revert "Update battery thresholds"
    This reverts commit 7a3126c926b207d1a37e5c441d05bc871ef29522.
2026-11-11 Suspend serial port while USB power is absent (#20)
    The serial port is suspended while the device runs without USB power,
    with its transmit line held low, and is restored when USB power
    returns. The battery voltage thresholds are raised and the firmware
    version is bumped to 1.4.
2026-11-14 Reorganize repository for unified release (#21)
    The standardized repository layout described in harp-tech/protocol#145
    is adopted. The top-level folders are renamed to lowercase, Interface
    is moved to software/dotnet, the ATxmega core is moved to its own
    folder, and the legacy generator project is removed. Package metadata
    and versioning come from the shared build files of the device template,
    with build output in a central artifacts folder.
    The firmware headers and register definitions are regenerated from
    device.yml and ios.yml, and the hand-written sources use the generated
    names. The firmware builds with a Makefile that the Atmel Studio
    project also runs, with each firmware and hardware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
2026-11-14 Align device page filename and title
2026-11-14 Align docs with firmware v1.4 behavior
    Repeater mode, status LED rates, button feedback, the low battery flash
    and clock resets on restart are corrected against the firmware, the
    clock lock error is quoted as Bonsai.Harp reports it, and the shared
    time base is described as timestamped on the same clock, consistent
    with the Harp website.
